dviracachas/Hardware-SI-Campus-Inteligente-UN/Hardware/ArchivosJLC/hardware_SI_BOM.xlsx

Id | Designator | Package | Quantity | Designation | Supplier and ref
1 | U9 | SOP65P640X120-8N | 1 | TPS2111APWR
2 | R4 | R_0603_1608Metric_Pad0.98x0.95mm_HandSolder | 1 | 240k
3 | R3 | R_0603_1608Metric_Pad0.98x0.95mm_HandSolder | 1 | 750k
4 | U5 | SOT-23-8 | 1 | MAX6369
5 | U4 | SOT-223-3_TabPin2 | 1 | LDL1117S33R
6 | R2,R8,R1,R7 | R_0805_2012Metric_Pad1.20x1.40mm_HandSolder | 4 | 1.5k
7 | C14 | C_0805_2012Metric_Pad1.18x1.45mm_HandSolder | 1 | 100nF
8 | C10,C2 | C_0805_2012Metric_Pad1.18x1.45mm_HandSolder | 2 | 1uF
9 | R13 | R_0805_2012Metric_Pad1.20x1.40mm_HandSolder | 1 | 680k
10 | C16,C17,C18,C15 | C_0805_2012Metric_Pad1.18x1.45mm_HandSolder | 4 | 0.1uF
11 | L1 | L_Bourns-SRN4018 | 1 | 1uH
12 | J1 | BarrelJack_Horizontal | 1 | Barrel_Jack_Switch
13 | SW1 | SW_CuK_OS102011MA1QN1_SPDT_Angled | 1 | SW_SPDT
14 | C7 | C_0805_2012Metric_Pad1.18x1.45mm_HandSolder | 1 | 100pF
15 | FB1 | R_0805_2012Metric_Pad1.20x1.40mm_HandSolder | 1 | FerriteBead
16 | C5,C3,C11,C4 | C_0805_2012Metric_Pad1.18x1.45mm_HandSolder | 4 | 4.7uF
17 | D5,D4,D6 | LED_0805_2012Metric_Pad1.15x1.40mm_HandSolder | 3 | LED
18 | R19,R10,R11,R12 | R_0805_2012Metric_Pad1.20x1.40mm_HandSolder | 4 | 470
19 | R5,R17,R9 | R_0805_2012Metric_Pad1.20x1.40mm_HandSolder | 3 | 10k
20 | R14 | R_0805_2012Metric_Pad1.20x1.40mm_HandSolder | 1 | 2.2M
21 | R6 | R_0805_2012Metric_Pad1.20x1.40mm_HandSolder | 1 | 1M
22 | C6 | C_0805_2012Metric_Pad1.18x1.45mm_HandSolder | 1 | 10uF
23 | J2 | PinSocket_1x07_P2.54mm_Vertical | 1 | Conn_01x07_Female
24 | C9 | C_0805_2012Metric_Pad1.18x1.45mm_HandSolder | 1 | 22uF
25 | TH1 | R_0603_1608Metric_Pad0.98x0.95mm_HandSolder | 1 | 10k
26 | U2 | VQFN-16-1EP_3x3mm_P0.5mm_EP1.6x1.6mm | 1 | BQ24072RGT
27 | U3 | WSON-8-1EP_2x2mm_P0.5mm_EP0.9x1.6mm | 1 | TPS61252DSG
28 | R16,R15 | R_0805_2012Metric_Pad1.20x1.40mm_HandSolder | 2 | 1k
29 | U8 | SOP-8_3.9x4.9mm_P1.27mm | 1 | CH340N
30 | U6 | SOT95P270X145-5N | 1 | MCP3021
31 | J3 | USB_Micro-B_Molex-105017-0001 | 1 | USB_B_Micro
32 | D2 | LED_0805_2012Metric_Pad1.15x1.40mm_HandSolder | 1 | CHRG_LED
33 | C1,C13,C12 | C_0805_2012Metric_Pad1.18x1.45mm_HandSolder | 3 | 100n
34 | D1 | LED_0805_2012Metric_Pad1.15x1.40mm_HandSolder | 1 | PGOOD_LED
35 | U7 | SOT-23-6 | 1 | USBLC6-2SC6
36 | R18 | R_0805_2012Metric_Pad1.20x1.40mm_HandSolder | 1 | 2.2k
37 | U1 | Onion_Omega2+ | 1 | OMEGA2+
38 | BT1 | BatteryHolder_MPD_BH-18650-PC2 | 1 | 3.7V
