dviracachas/Hardware-SI-Campus-Inteligente-UN/Carcasa/ArchivosSTL/switch.stl

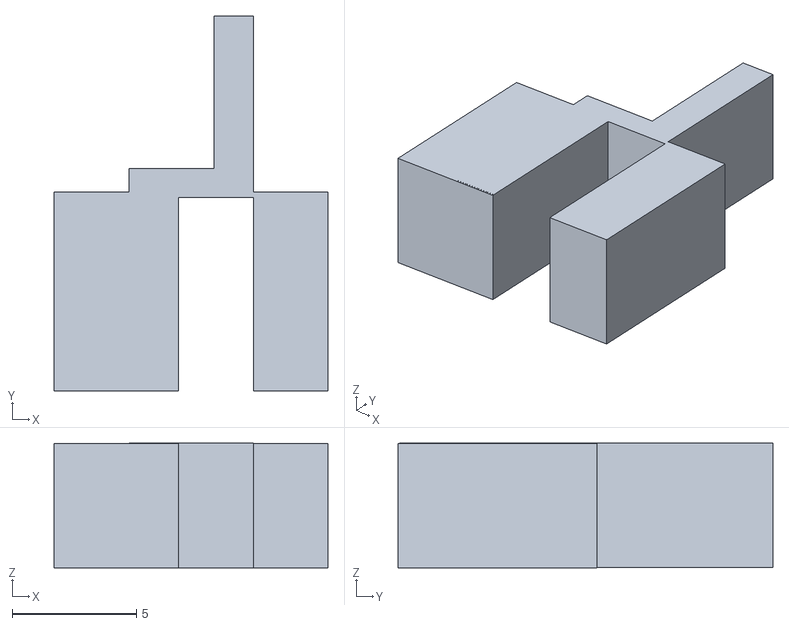
[picture p1: CAD file, 2022-06-30]
Carcasa/ArchivosSTL/switch.stl
11.0 x 15.1 x 5.01
