dviracachas/Hardware-SI-Campus-Inteligente-UN/Carcasa/Caja.FCStd

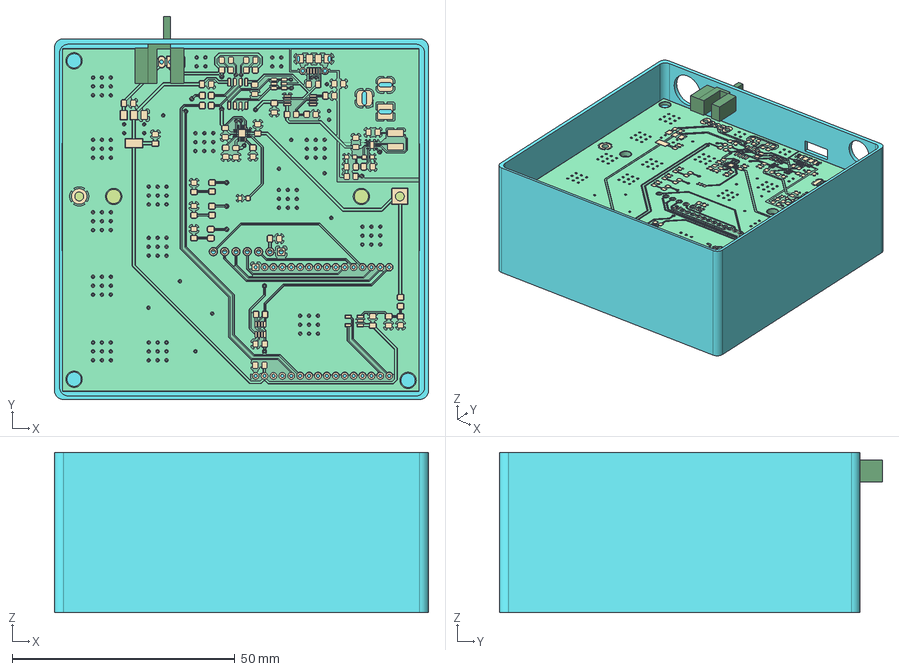
[picture p2: CAD file, 2022-06-30]
Carcasa/Caja.FCStd
84.0 x 86.0 x 36.0 mm
Caja
Pcb_4ceb
topPads_4ceb
topTracks_4ceb
topZones_4ceb
botPads_4ceb
botTracks_4ceb
botZones_4ceb
Bateria
Switch
