dviracachas/Hardware-SI-Campus-Inteligente-UN/Hardware/LTC4085EDEPBF/LTC4085EDEPBF.step

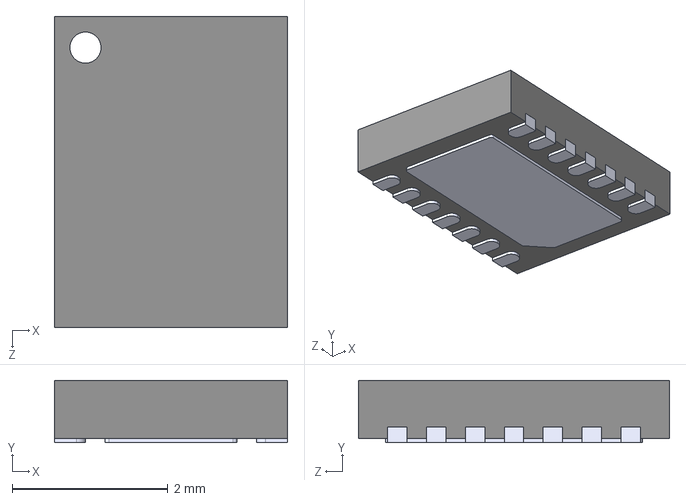
[picture p3: CAD file, 2022-06-30]
Hardware/LTC4085EDEPBF/LTC4085EDEPBF.step
3.00 x 0.8 x 4.00 mm
