dviracachas/Hardware-SI-Campus-Inteligente-UN/Hardware/MCP3021A5T-E_OT/MCP3021A5T-E_OT.step

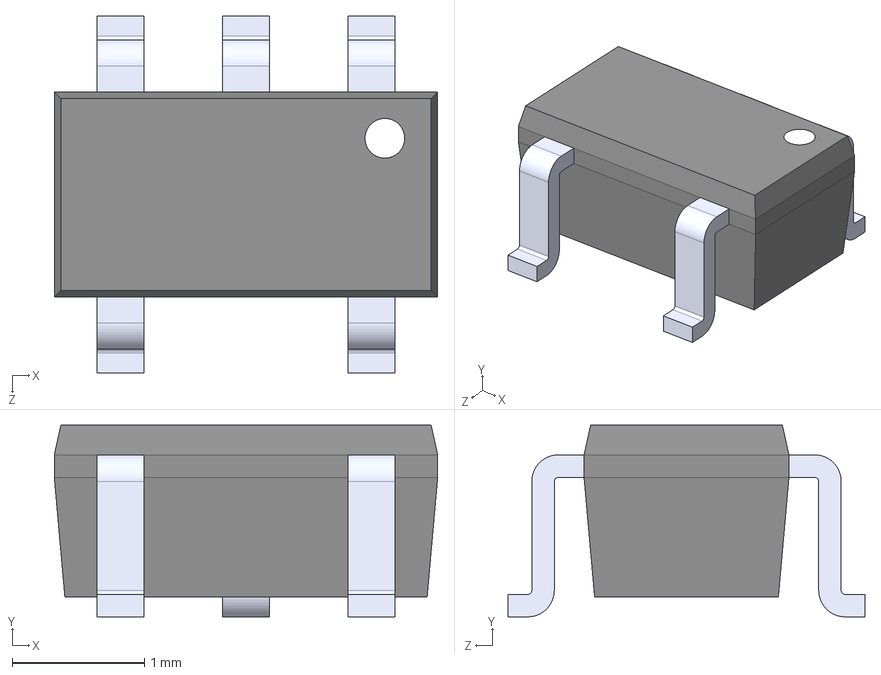
[picture p4: CAD file, 2022-06-30]
Hardware/MCP3021A5T-E_OT/MCP3021A5T-E_OT.step
2.90 x 1.45 x 2.70 mm
