dviracachas/Hardware-SI-Campus-Inteligente-UN/Hardware/TPS2111APWR/TPS2111APWR.step

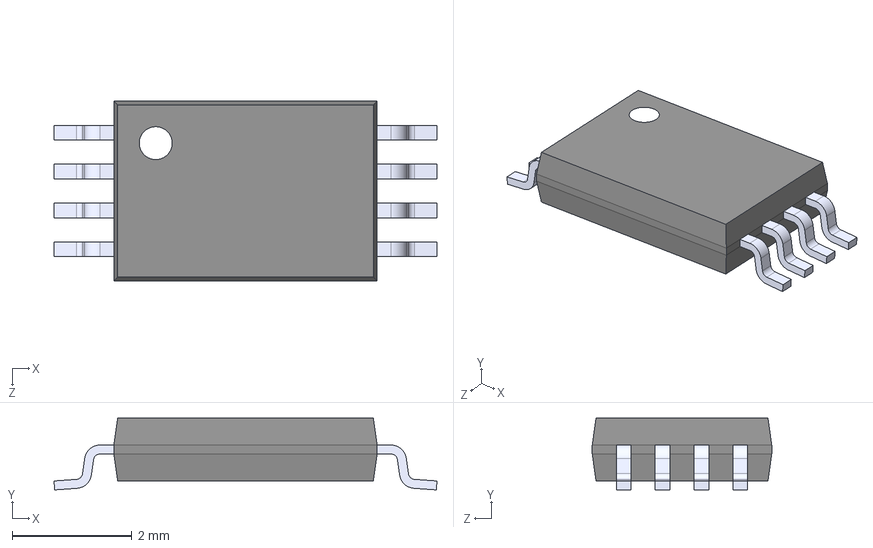
[picture p5: CAD file, 2022-06-30]
Hardware/TPS2111APWR/TPS2111APWR.step
6.40 x 1.20 x 3.00 mm
