dviracachas/Hardware-SI-Campus-Inteligente-UN/Carcasa/ArchivosSTL/tapa_bateria.stl

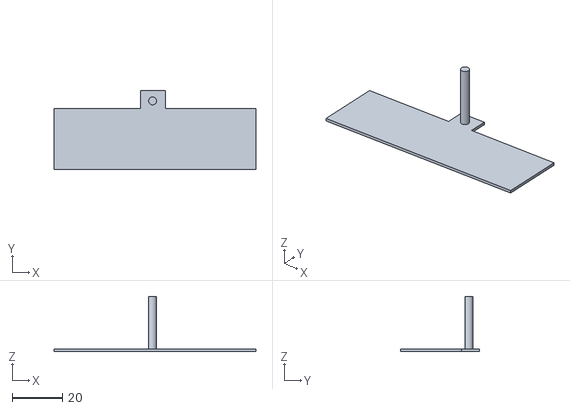
[picture p6: CAD file, 2022-06-30]
Carcasa/ArchivosSTL/tapa_bateria.stl
80.3 x 31.3 x 22.0
