dviracachas/Hardware-SI-Campus-Inteligente-UN/Carcasa/ArchivosSTL/carcasa_principal.stl

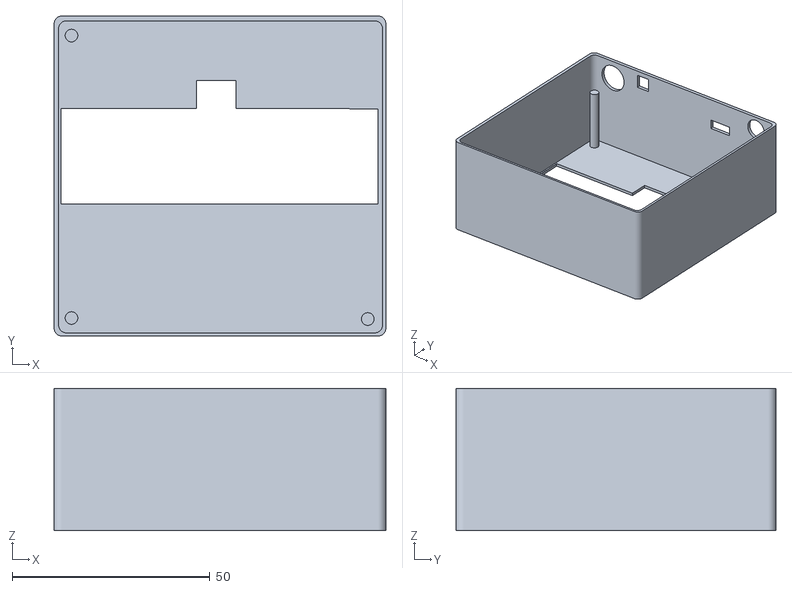
[picture p7: CAD file, 2022-06-30]
Carcasa/ArchivosSTL/carcasa_principal.stl
84.0 x 81.0 x 36.0
