dviracachas/Hardware-SI-Campus-Inteligente-UN/Carcasa/ArchivosSTL/tapa_con_letras.stl

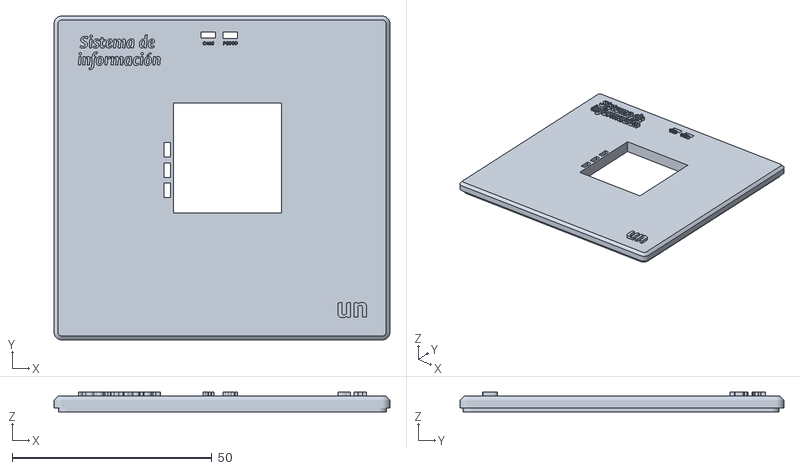
[picture p8: CAD file, 2022-06-30]
Carcasa/ArchivosSTL/tapa_con_letras.stl
84.0 x 81.0 x 5.00
