dviracachas/Hardware-SI-Campus-Inteligente-UN/Hardware/hardware_SI.kicad_pcb

## KiCad design Hardware/hardware_SI.kicad_pcb (2022-06-30)

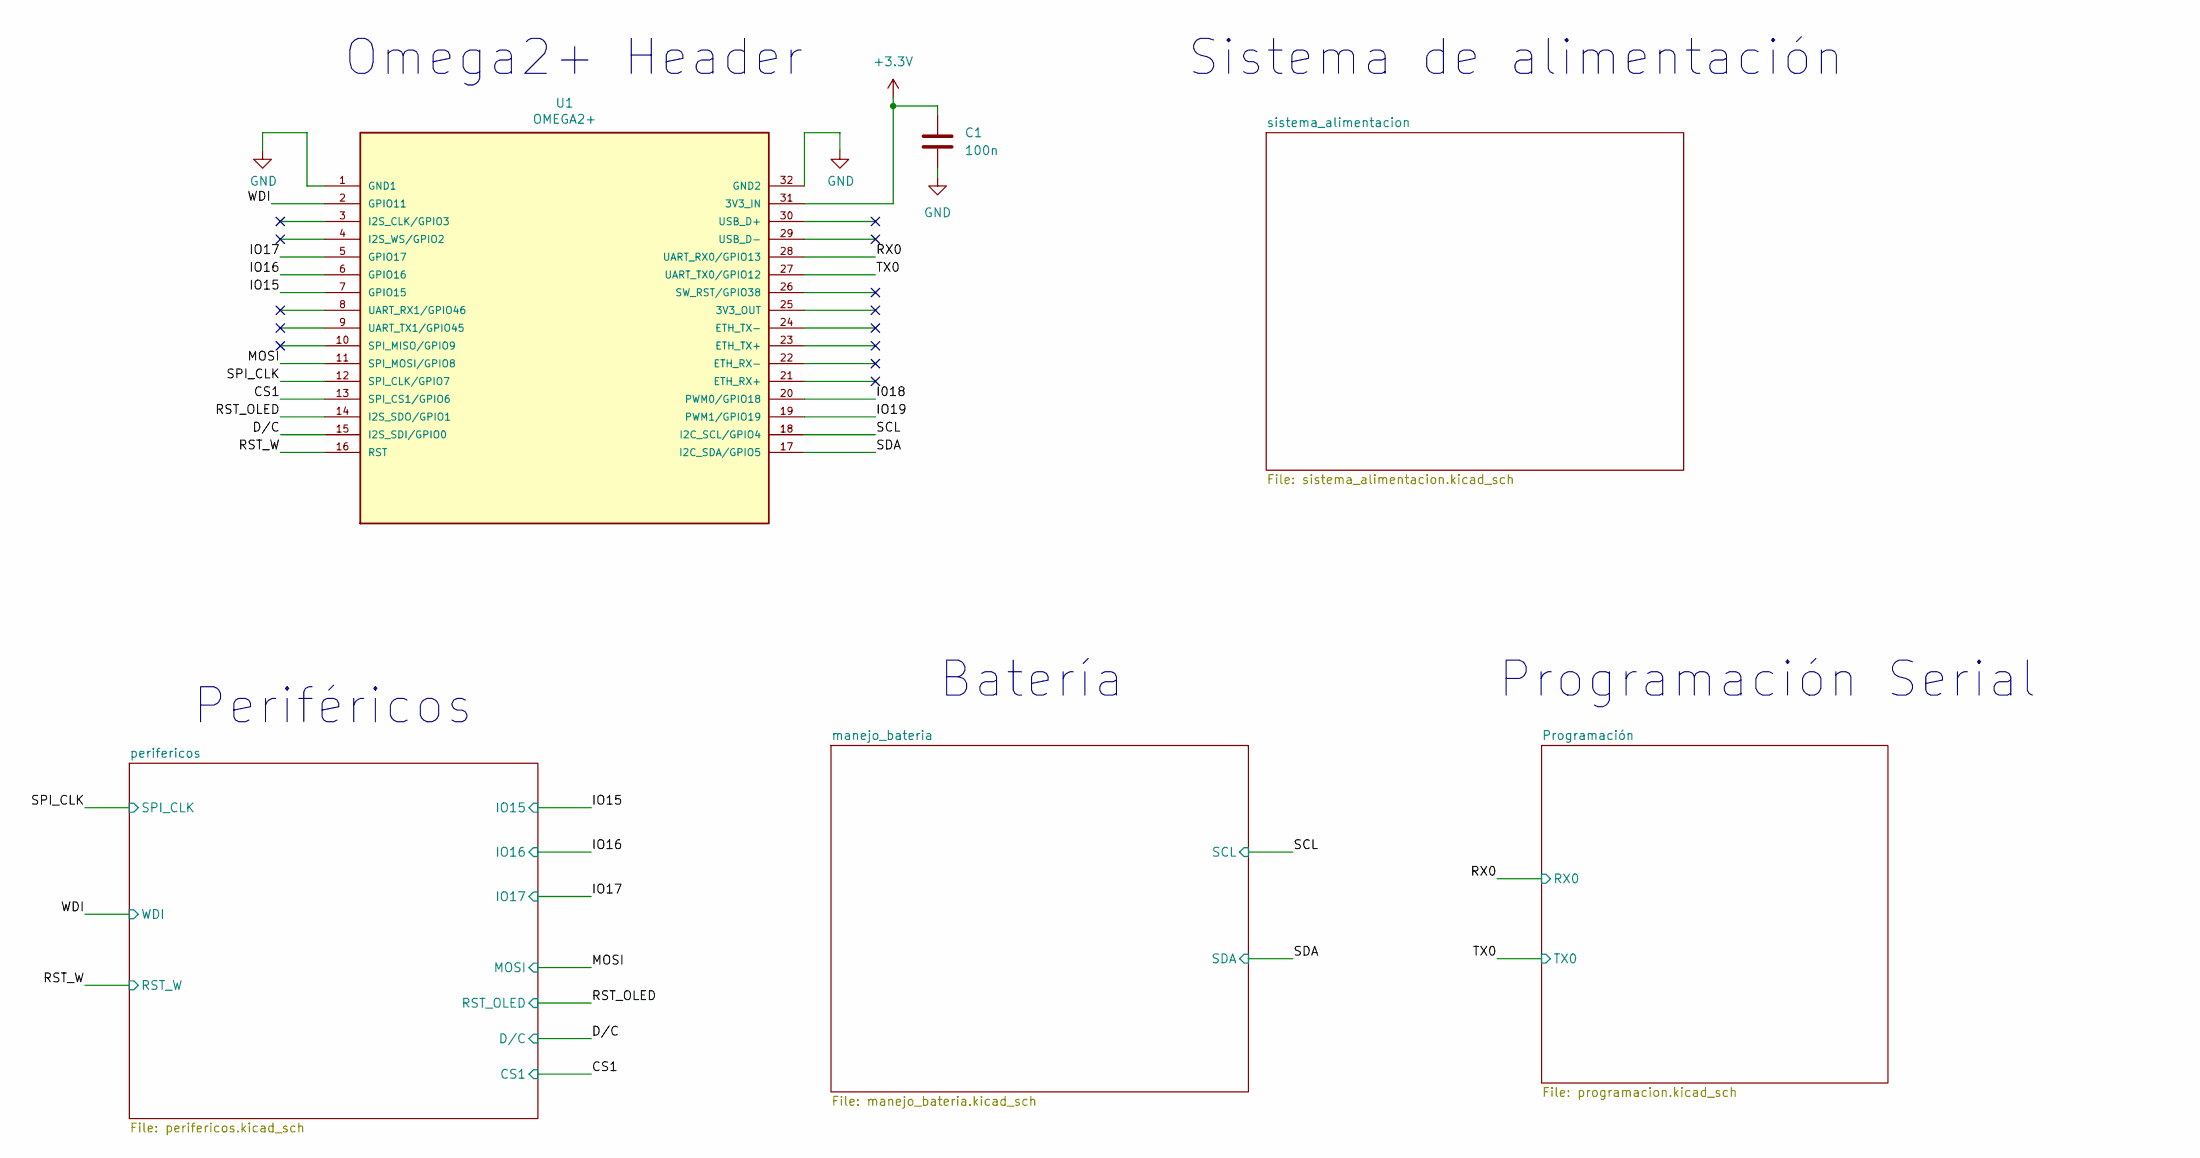
[picture p9: schematic hardware_SI.kicad_sch]

Parts:
C1: 100n; C_0805_2012Metric_Pad1.18x1.45mm_HandSolder
U1: OMEGA2+; Onion_Omega2+

Connections:
+3V3: C1.1, U1.31 (3V3_IN); also elsewhere on the board
/CS1: U1.13 (SPI_CS1/GPIO6); also elsewhere on the board
/D/C: U1.15 (I2S_SDI/GPIO0); also elsewhere on the board
/I018: U1.20 (PWM0/GPIO18)
/IO15: U1.7 (GPIO15); also elsewhere on the board
/IO16: U1.6 (GPIO16); also elsewhere on the board
/IO17: U1.5 (GPIO17); also elsewhere on the board
/IO19: U1.19 (PWM1/GPIO19)
/MOSI: U1.11 (SPI_MOSI/GPIO8); also elsewhere on the board
/RST_OLED: U1.14 (I2S_SDO/GPIO1); also elsewhere on the board
/RST_W: U1.16 (RST); also elsewhere on the board
/RX0: U1.28 (UART_RX0/GPIO13); also elsewhere on the board
/SCL: U1.18 (I2C_SCL/GPIO4); also elsewhere on the board
/SDA: U1.17 (I2C_SDA/GPIO5); also elsewhere on the board
/SPI_CLK: U1.12 (SPI_CLK/GPIO7); also elsewhere on the board
/TX0: U1.27 (UART_TX0/GPIO12); also elsewhere on the board
/WDI: U1.2 (GPIO11); also elsewhere on the board
GND: C1.2, U1.1 (GND1), U1.32 (GND2); also elsewhere on the board

Notes on the sheet:
Omega2+ Header
Programación Serial
Periféricos
Sistema de alimentación
Batería

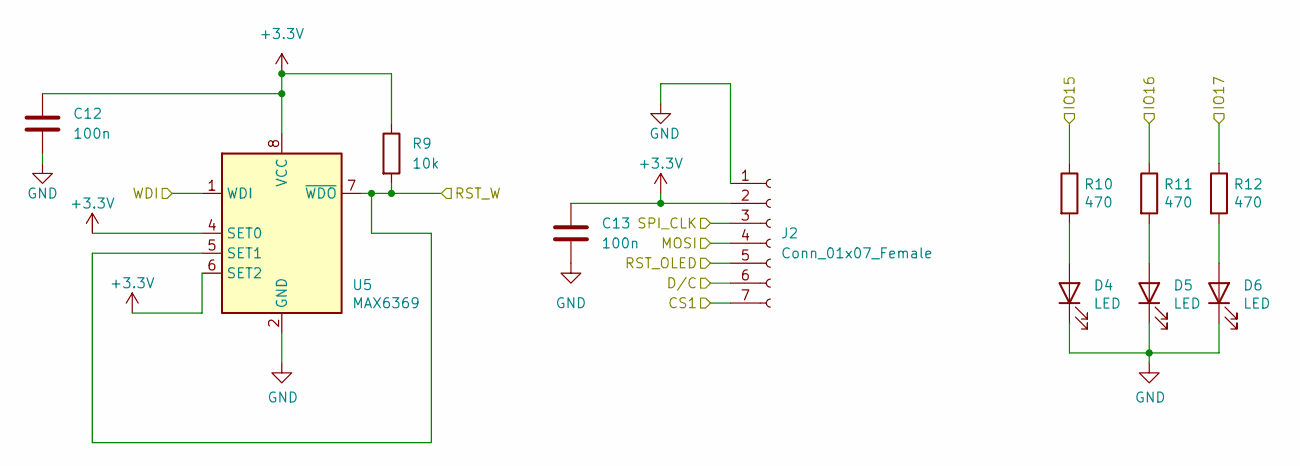
[picture p10: schematic perifericos.kicad_sch]

Parts:
C12, C13: 100n; C_0805_2012Metric_Pad1.18x1.45mm_HandSolder
D4, D5, D6: LED; LED_0805_2012Metric_Pad1.15x1.40mm_HandSolder
J2: Conn_01x07_Female; PinSocket_1x07_P2.54mm_Vertical
R9: 10k; R_0805_2012Metric_Pad1.20x1.40mm_HandSolder
R10, R11, R12: 470; R_0805_2012Metric_Pad1.20x1.40mm_HandSolder
U5: MAX6369; SOT-23-8

Connections:
+3V3: C12.1, C13.1, J2.2, R9.1, U5.4 (SET0), U5.6 (SET2), U5.8 (VCC); also elsewhere on the board
/CS1: J2.7; also elsewhere on the board
/D/C: J2.6; also elsewhere on the board
/IO15: R10.1; also elsewhere on the board
/IO16: R11.1; also elsewhere on the board
/IO17: R12.1; also elsewhere on the board
/MOSI: J2.4; also elsewhere on the board
/RST_OLED: J2.5; also elsewhere on the board
/RST_W: R9.2, U5.5 (SET1), U5.7 (~WDO); also elsewhere on the board
/SPI_CLK: J2.3; also elsewhere on the board
/WDI: U5.1 (WDI); also elsewhere on the board
GND: C12.2, C13.2, D4.1 (K), D5.1 (K), D6.1 (K), J2.1, U5.2 (GND); also elsewhere on the board
unnamed: D4.2 (A), R10.2
unnamed: D5.2 (A), R11.2
unnamed: D6.2 (A), R12.2

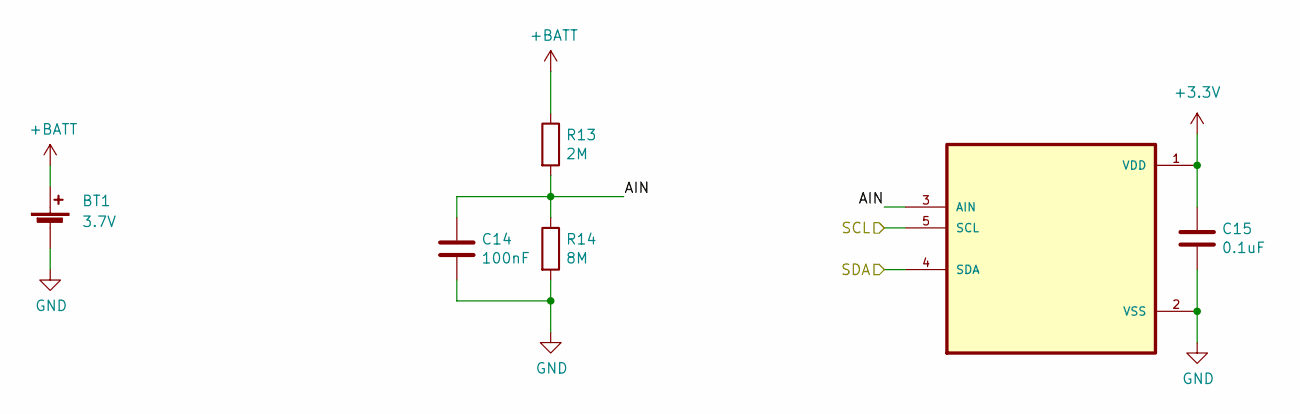
[picture p11: schematic manejo_bateria.kicad_sch]

Parts:
BT1: 3.7V; BatteryHolder_MPD_BH-18650-PC2
C14: 100nF; C_0805_2012Metric_Pad1.18x1.45mm_HandSolder
C15: 0.1uF; C_0805_2012Metric_Pad1.18x1.45mm_HandSolder
R13: 2M; R_0805_2012Metric_Pad1.20x1.40mm_HandSolder
R14: 8M; R_0805_2012Metric_Pad1.20x1.40mm_HandSolder
U6: MCP3021; SOT95P270X145-5N

Connections:
+3V3: C15.1, U6.1 (VDD); also elsewhere on the board
+BATT: BT1.1 (+), R13.1; also elsewhere on the board
/SCL: U6.5 (SCL); also elsewhere on the board
/SDA: U6.4 (SDA); also elsewhere on the board
/manejo_bateria/AIN: C14.1, R13.2, R14.1, U6.3 (AIN)
GND: BT1.2 (-), C14.2, C15.2, R14.2, U6.2 (VSS); also elsewhere on the board

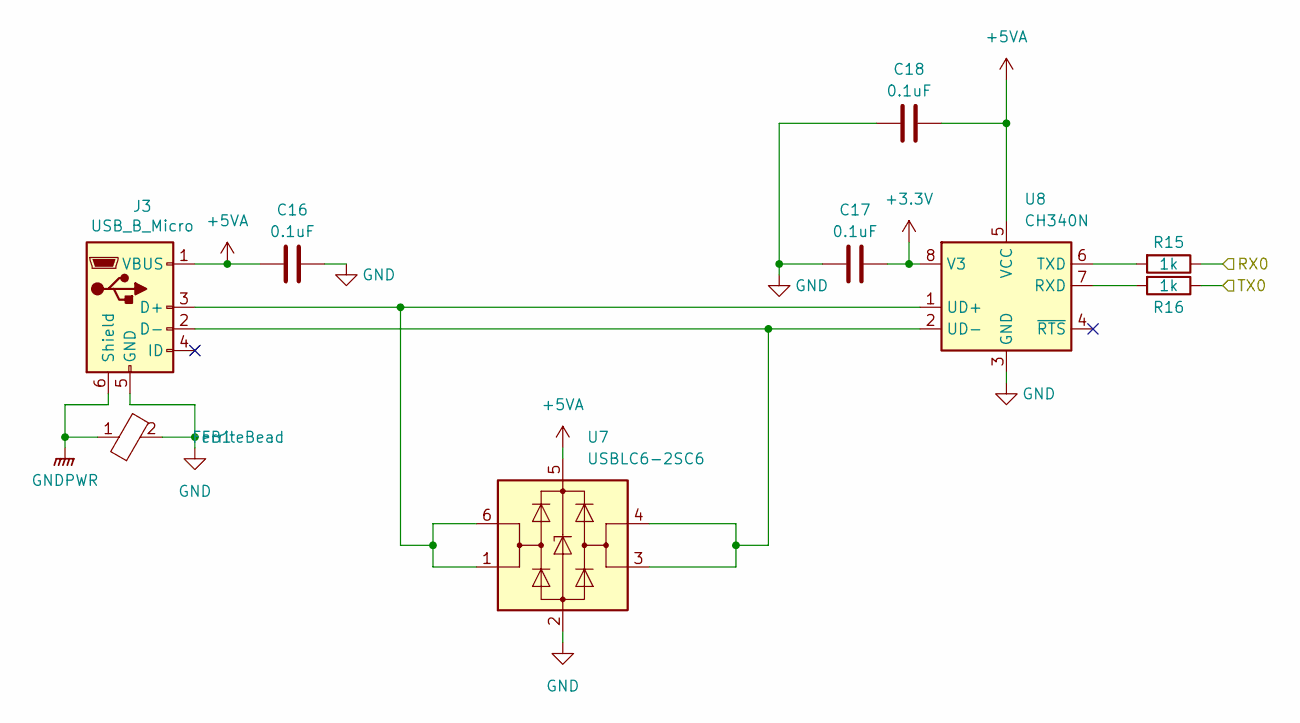
[picture p12: schematic programacion.kicad_sch]

Parts:
C16, C17, C18: 0.1uF; C_0805_2012Metric_Pad1.18x1.45mm_HandSolder
FB1: FerriteBead; R_0805_2012Metric_Pad1.20x1.40mm_HandSolder
J3: USB_B_Micro; USB_Micro-B_Molex-105017-0001
R15, R16: 1k; R_0805_2012Metric_Pad1.20x1.40mm_HandSolder
U7: USBLC6-2SC6; SOT-23-6
U8: CH340N; SOP-8_3.9x4.9mm_P1.27mm

Connections:
+3V3: C17.1, U8.8 (V3); also elsewhere on the board
+5VA: C16.2, C18.1, J3.1 (VBUS), U7.5 (VBUS), U8.5 (VCC); also elsewhere on the board
/RX0: R15.1; also elsewhere on the board
/TX0: R16.1; also elsewhere on the board
GND: C16.1, C17.2, C18.2, FB1.2, J3.5 (GND), U7.2 (GND), U8.3 (GND); also elsewhere on the board
GNDPWR: FB1.1, J3.6 (Shield); also elsewhere on the board
unnamed: J3.2 (D-), U7.3 (I/O2), U7.4 (I/O2), U8.2 (UD-)
unnamed: J3.3 (D+), U7.1 (I/O1), U7.6 (I/O1), U8.1 (UD+)
unnamed: R15.2, U8.6 (TXD)
unnamed: R16.2, U8.7 (RXD)

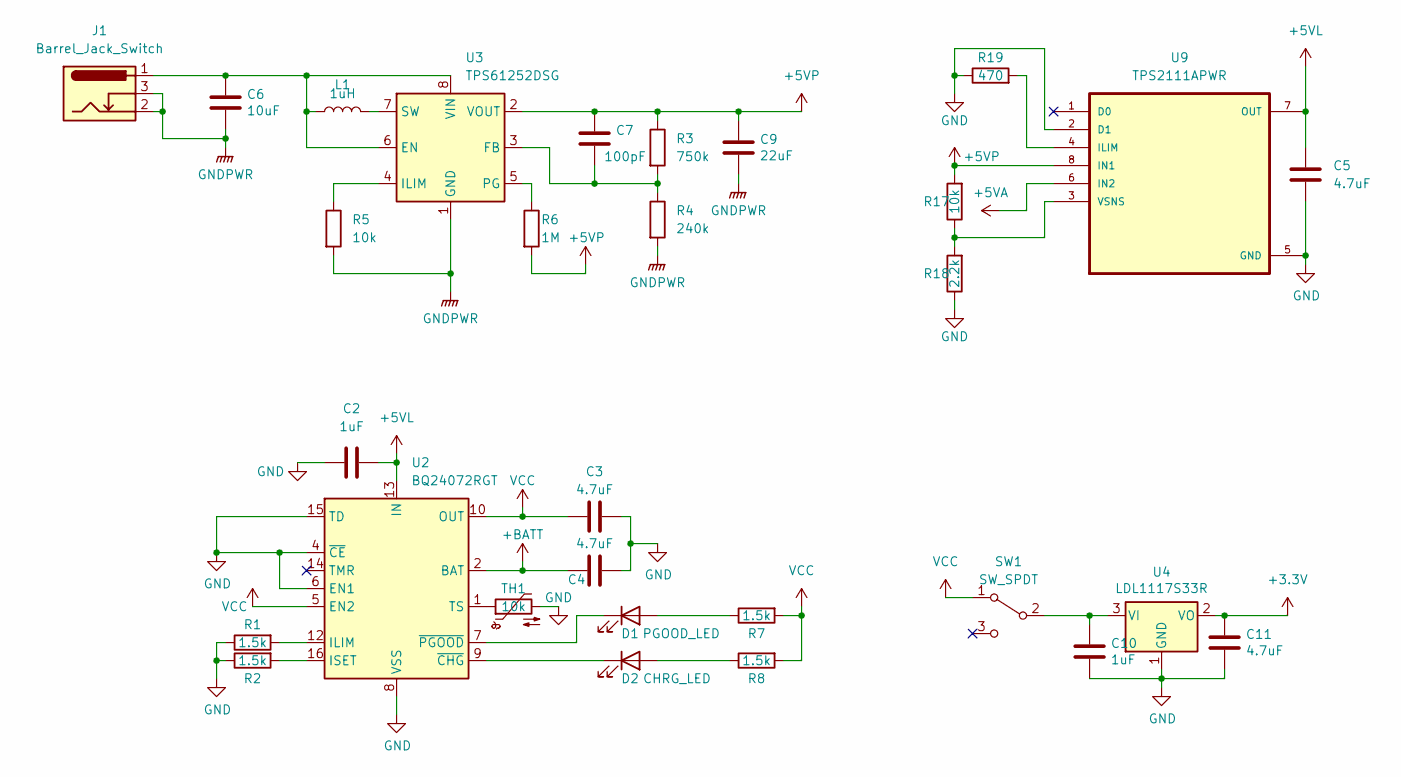
[picture p13: schematic sistema_alimentacion.kicad_sch]

Parts:
C2, C10: 1uF; C_0805_2012Metric_Pad1.18x1.45mm_HandSolder
C3, C4, C5, C11: 4.7uF; C_0805_2012Metric_Pad1.18x1.45mm_HandSolder
C6: 10uF; C_0805_2012Metric_Pad1.18x1.45mm_HandSolder
C7: 100pF; C_0805_2012Metric_Pad1.18x1.45mm_HandSolder
C9: 22uF; C_0805_2012Metric_Pad1.18x1.45mm_HandSolder
D1: PGOOD_LED; LED_0805_2012Metric_Pad1.15x1.40mm_HandSolder
D2: CHRG_LED; LED_0805_2012Metric_Pad1.15x1.40mm_HandSolder
J1: Barrel_Jack_Switch; BarrelJack_Horizontal
L1: 1uH; L_Bourns-SRN4018
R1, R2, R7, R8: 1.5k; R_0805_2012Metric_Pad1.20x1.40mm_HandSolder
R3: 750k; R_0603_1608Metric_Pad0.98x0.95mm_HandSolder
R4: 240k; R_0603_1608Metric_Pad0.98x0.95mm_HandSolder
R5, R17: 10k; R_0805_2012Metric_Pad1.20x1.40mm_HandSolder
R6: 1M; R_0805_2012Metric_Pad1.20x1.40mm_HandSolder
R18: 2.2k; R_0805_2012Metric_Pad1.20x1.40mm_HandSolder
R19: 470; R_0805_2012Metric_Pad1.20x1.40mm_HandSolder
SW1: SW_SPDT; SW_CuK_OS102011MA1QN1_SPDT_Angled
TH1: 10k; R_0603_1608Metric_Pad0.98x0.95mm_HandSolder
U2: BQ24072RGT; VQFN-16-1EP_3x3mm_P0.5mm_EP1.6x1.6mm
U3: TPS61252DSG; WSON-8-1EP_2x2mm_P0.5mm_EP0.9x1.6mm
U4: LDL1117S33R; SOT-223-3_TabPin2
U9: TPS2111APWR; SOP65P640X120-8N

Connections:
+3V3: C11.1, U4.2 (VO); also elsewhere on the board
+5VA: U9.6 (IN2); also elsewhere on the board
+5VL: C2.2, C5.1, U2.13 (IN), U9.7 (OUT)
+5VP: C7.1, C9.1, R3.1, R6.2, R17.2, U3.2 (VOUT), U9.8 (IN1)
+BATT: C4.1, U2.2 (BAT), U2.3 (BAT); also elsewhere on the board
GND: C2.1, C3.2, C4.2, C5.2, C10.2, C11.2, R1.1, R2.1, R18.1, R19.1, TH1.2, U2.4 (~CE), U2.6 (EN1), U2.8 (VSS), U2.15 (TD), U2.17 (VSS), U4.1 (GND), U9.2 (D1), U9.5 (GND); also elsewhere on the board
GNDPWR: C6.2, C9.2, J1.2, J1.3, R4.2, R5.2, U3.1 (GND), U3.9 (GND); also elsewhere on the board
unnamed: C6.1, J1.1, L1.1, U3.6 (EN), U3.8 (VIN)
unnamed: C7.2, R3.2, R4.1, U3.3 (FB)
unnamed: C10.1, SW1.2 (B), U4.3 (VI)
unnamed: D1.1 (K), U2.7 (~PGOOD)
unnamed: D1.2 (A), R7.1
unnamed: D2.1 (K), U2.9 (~CHG)
unnamed: D2.2 (A), R8.1
unnamed: L1.2, U3.7 (SW)
unnamed: R1.2, U2.12 (ILIM)
unnamed: R2.2, U2.16 (ISET)
unnamed: R5.1, U3.4 (ILIM)
unnamed: R6.1, U3.5 (PG)
unnamed: R17.1, R18.2, U9.3 (VSNS)
unnamed: R19.2, U9.4 (ILIM)
unnamed: TH1.1, U2.1 (TS)
VCC: C3.1, R7.2, R8.2, SW1.1 (A), U2.5 (EN2), U2.10 (OUT), U2.11 (OUT)

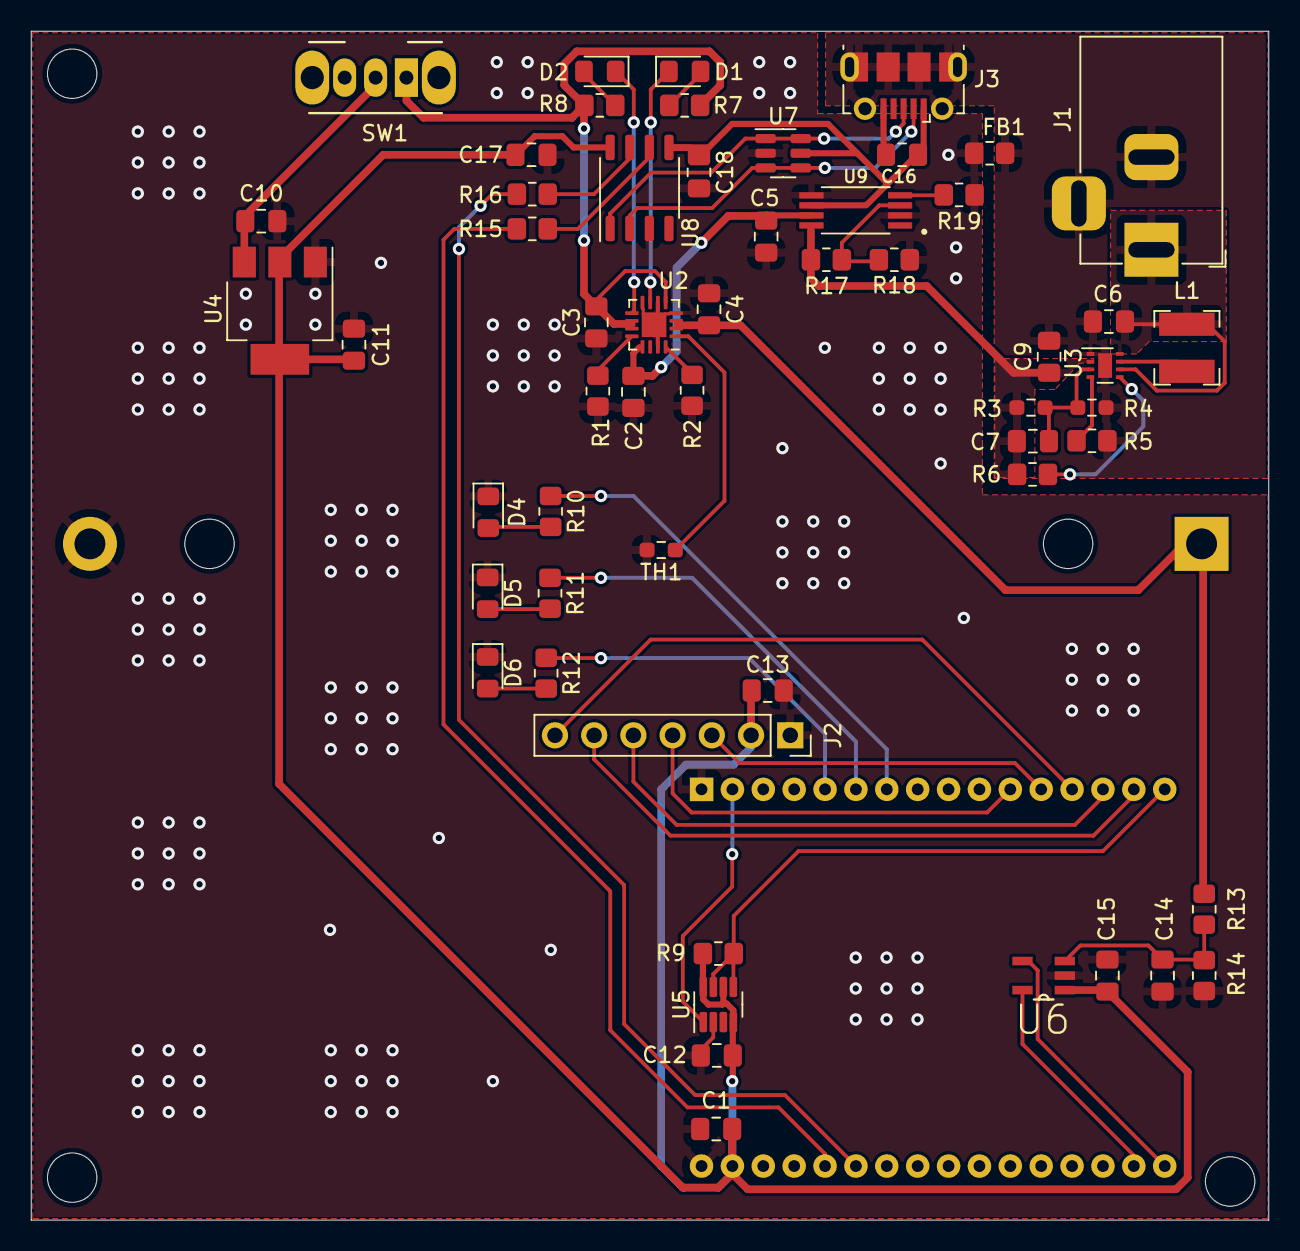
[picture p14: board hardware_SI.kicad_pcb from above]

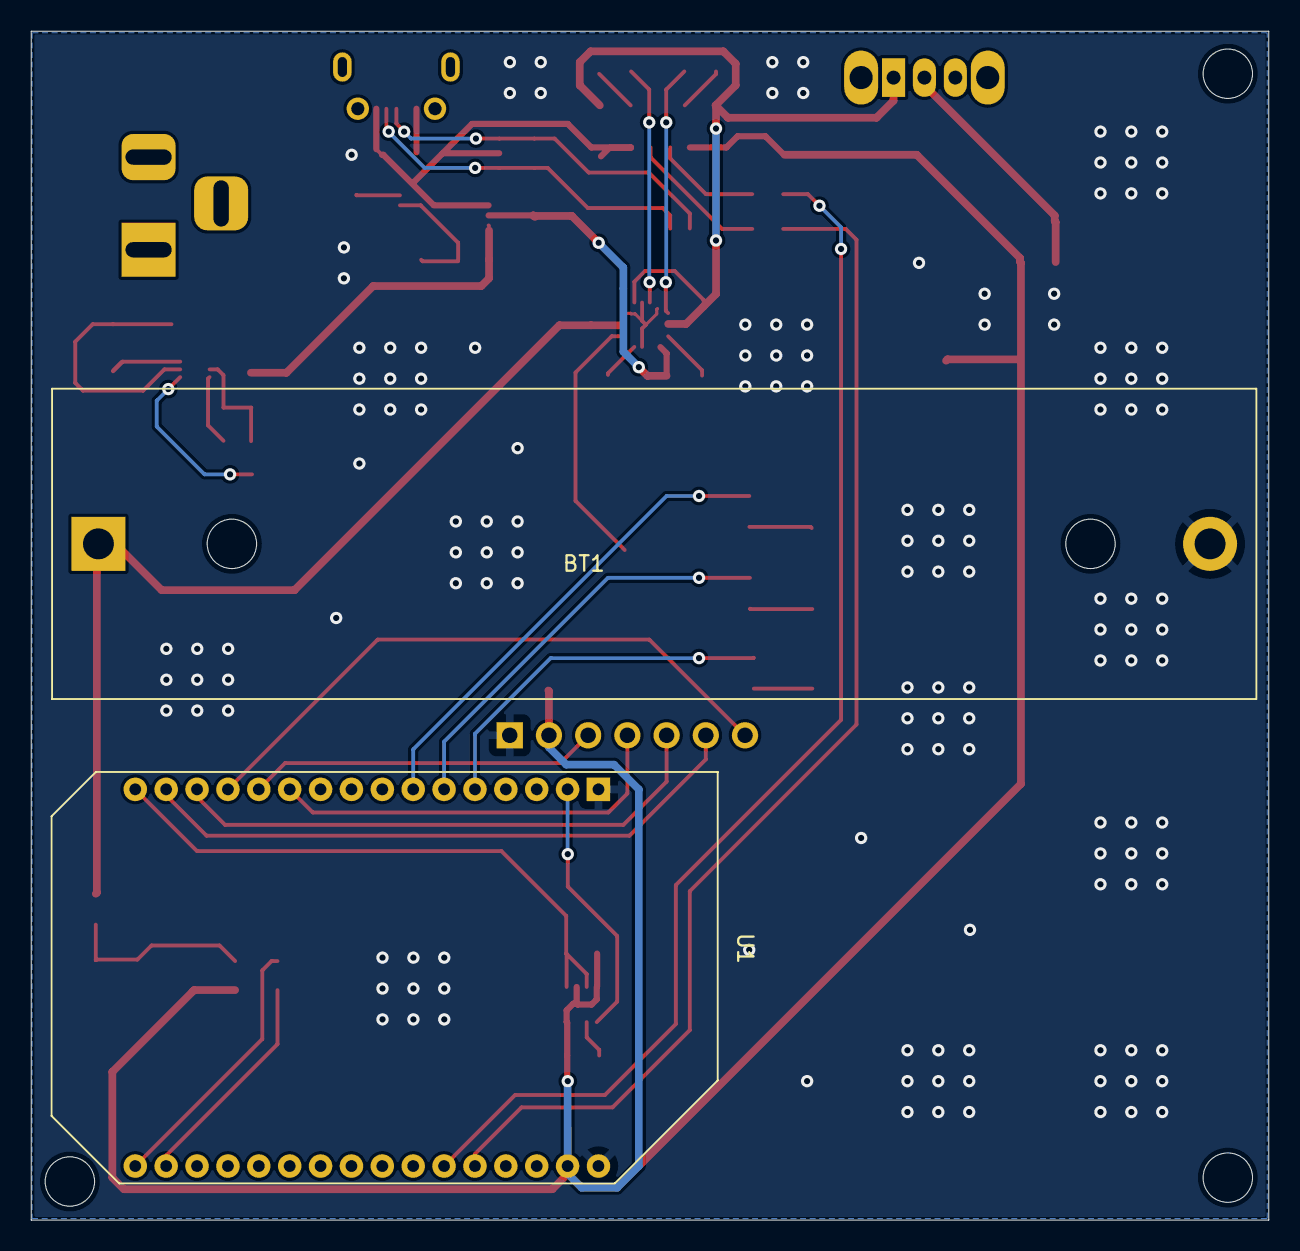
[picture p15: board hardware_SI.kicad_pcb from below]

Board: 2 copper layers, 80.2 x 77.0 mm, 58 parts (2 on the bottom side), 45 nets.
