dviracachas/Hardware-SI-Campus-Inteligente-UN/Software/task_management/mqttPublish.py

import paho.mqtt.client as mqtt
from random import randrange, uniform
import time

mqttBroker = "127.0.0.1"
client = mqtt.Client("Temperature_Outside")
client.connect(mqttBroker)

while True:
    randNumber = randrange(10)
    client.publish("TEMPERATURE", randNumber)
    print("Just published " + str(randNumber) + " to Topic TEMPERATURE")
    time.sleep(1)
