dviracachas/Hardware-SI-Campus-Inteligente-UN/Software/task_management/un_logo.py

un_matrix = [
[40, 41, 42, 43, 44, 45, 46, 47, 48],
[36, 37, 38, 39, 40, 41, 42, 43, 44, 45, 46, 47, 48, 49, 50, 51, 52],
[33, 34, 35, 36, 37, 38, 39, 40, 41, 42, 43, 44, 45, 46, 47, 48, 49, 50, 51, 52, 53, 54],
[32, 33, 34, 35, 36, 37, 38, 39, 40, 41, 42, 43, 44, 45, 46, 47, 48, 49, 50, 51, 52, 53, 54, 55],
[31, 32, 35, 36, 37, 38, 39, 40, 43, 44, 53, 54, 55, 56],
[30, 31, 32, 35, 36, 37, 38, 39, 40, 43, 44, 48, 49, 50, 51, 54, 55, 56, 57],
[30, 31, 32, 35, 36, 37, 38, 39, 40, 43, 44, 47, 48, 49, 50, 51, 52, 55, 56, 57],
[30, 31, 32, 35, 36, 37, 38, 39, 40, 43, 44, 47, 48, 49, 50, 51, 52, 55, 56, 57],
[30, 31, 32, 33, 36, 37, 38, 39, 43, 44, 47, 48, 49, 50, 51, 52, 55, 56, 57],
[31, 32, 33, 34, 43, 44, 47, 48, 49, 50, 51, 52, 55, 56],
[32, 33, 34, 35, 36, 37, 38, 39, 40, 41, 42, 43, 44, 45, 46, 47, 48, 49, 50, 51, 52, 53, 54, 55],
[33, 34, 35, 36, 37, 38, 39, 40, 41, 42, 43, 44, 45, 46, 47, 48, 49, 50, 51, 52, 53, 54],
[36, 37, 38, 39, 40, 41, 42, 43, 44, 45, 46, 47, 48, 49, 50, 51, 52],
[40, 41, 42, 43, 44, 45, 46, 47, 48]
]
