dviracachas/Hardware-SI-Campus-Inteligente-UN/(commit log)

2022-04-13 Esq onion power doc v1
    [hardware_SI.sch]
2022-04-15 Adelanto en esquemático
    [hardware_SI.sch]
2022-04-19 Sistema de Alimentación
    - Se agrega esquemático de sistema de alimentación basado en LTC4058.
    - Se revisan y cambian las etiquetas necesarias para conectar los circuitos.
    - Se cambia el tipo de LCD a uno con interfaz SPI.
    - Se ajustan detalles varios del esquemático.
    [LTC4085EDEPBF.step, hardware_SI.kicad_sch]
2022-05-08 Primer diseño de carcasa
    [Caja.scad, Tapa.scad]
2022-05-10 Conversor DC-DC y puerto panel solar
    - Se agrega en el esquemático el puerto de entrada del panel solar y se conecta a un convertidor DC-DC
    [hardware_SI.kicad_sch]
2022-05-10 Asignación de huellas
    - Se asignaron las huellas de los componentes del esquemático
    [hardware_SI.kicad_sch]
2022-05-10 Corrección de errores
    - Se corrigen errores relacionados a conexiones y huellas.
    [MCP3021A5T-E_OT.step, hardware_SI.kicad_pcb, hardware_SI.kicad_sch]
2022-05-10 Disposición preliminar PCB
    [hardware_SI.kicad_pcb]
2022-05-11 etiquetas y hojas jerárquicas
    Agrupación de subsistemas en hojas jerárquicas y cambios de etiquetas globales por locales y jerárquicas
    [hardware_SI.kicad_sch, manejo_bateria.kicad_sch, perifericos.kicad_sch, sistema_alimentacion.kicad_sch]
2022-05-15 Etq compon, C desacop, ferrita
    [hardware_SI.kicad_sch, manejo_bateria.kicad_sch, perifericos.kicad_sch, sistema_alimentacion.kicad_sch]
2022-05-16 mod_WD, etiquetas y clocks
    [hardware_SI.kicad_sch, perifericos.kicad_sch, sistema_alimentacion.kicad_sch]
2022-05-17 USB Serial, huellas y correcciones ERC
    - Se agregaron componentes para la comunicación serial con la Omega2+.
    - Se actualizaron huellas en función de la disponibilidad de los componentes.
    - Se ejecutó el ERC y se solucionaron los errores mostrados.
    [hardware_SI.kicad_sch, manejo_bateria.kicad_sch, perifericos.kicad_sch, programacion.kicad_sch, sistema_alimentacion.kicad_sch]
2022-05-17 Definiciones PCB
    - Se agregan definiciones para la creación de la PCB.
    [hardware_SI.kicad_pcb, hardware_SI.kicad_sch, manejo_bateria.kicad_sch, perifericos.kicad_sch, programacion.kicad_sch, sistema_alimentacion.kicad_sch]
2022-05-17 Rutas de PCB
    - Se realiza la PCB y se asignan sus respectivas rutas.
    [hardware_SI.kicad_pcb]
2022-05-20 Cambio en alimentación y zona GNDPWR
    - Debido a los tiempos de entrega del LTC4085, se cambia el sistema de alimentación, agregando un selector automático de fuente y un integrado de manejo de batería.
    - En consecuencia de lo anterior, se usa un LDO con menor voltaje de dropout.
    - Se cambia el convertidor DC-DC debido a su alto precio.
    - En cuanto a PCB, se completa el circuito del convertidor DC-DC y la zona de GNPWR.
    [TPS2111APWR.step, hardware_SI.kicad_pcb, hardware_SI.kicad_sch, manejo_bateria.kicad_sch, programacion.kicad_sch, sistema_alimentacion.kicad_sch]
2022-05-21 PCB corregido
    [hardware_SI.kicad_pcb]
2022-05-23 Archivos de fabricación y cambios menores
    - Se generan los archivos de fabricación.
    - Se cambian algunas resistencias por valores más comerciales.
    [hardware_SI.kicad_pcb, hardware_SI.kicad_sch, hardware_SI_BOM.xlsx, manejo_bateria.kicad_sch, programacion.kicad_sch, sistema_alimentacion.kicad_sch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]
2022-05-31 Segundo diseño
    [Caja.FCStd]
2022-06-18 Diseño de carcasa terminada
    [Caja.FCStd, Caja.scad, Tapa.scad]
2022-06-22 Huecos LEDs faltantes añadidos
    [Caja.FCStd]
2022-06-22 Archivos de fabricación
    - Se generan los archivos STL para fabricación.
    - Se cambian detalles menores del modelo y se cambia la fuente de letra de la carcasa.
    [Caja.FCStd, carcasa_principal.stl, switch.stl, tapa_bateria.stl, tapa_con_letras.stl]
2022-06-30 Carcasa y software preliminar
    - Se agrega la carcasa al main.
    - Se agrega una versión preliminar de software con inicialización de Hardware y diseño básico de portal web.
    [LTC4085EDEPBF.step, MCP3021A5T-E_OT.step, TPS2111APWR.step, hardware_SI.kicad_pcb, hardware_SI.kicad_sch, hardware_SI.sch, hardware_SI_BOM.xlsx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]
